sillyhatday/IV-3-Computer-Status-Monitor/IV-3-computer-status-monitor-schematic.pdf

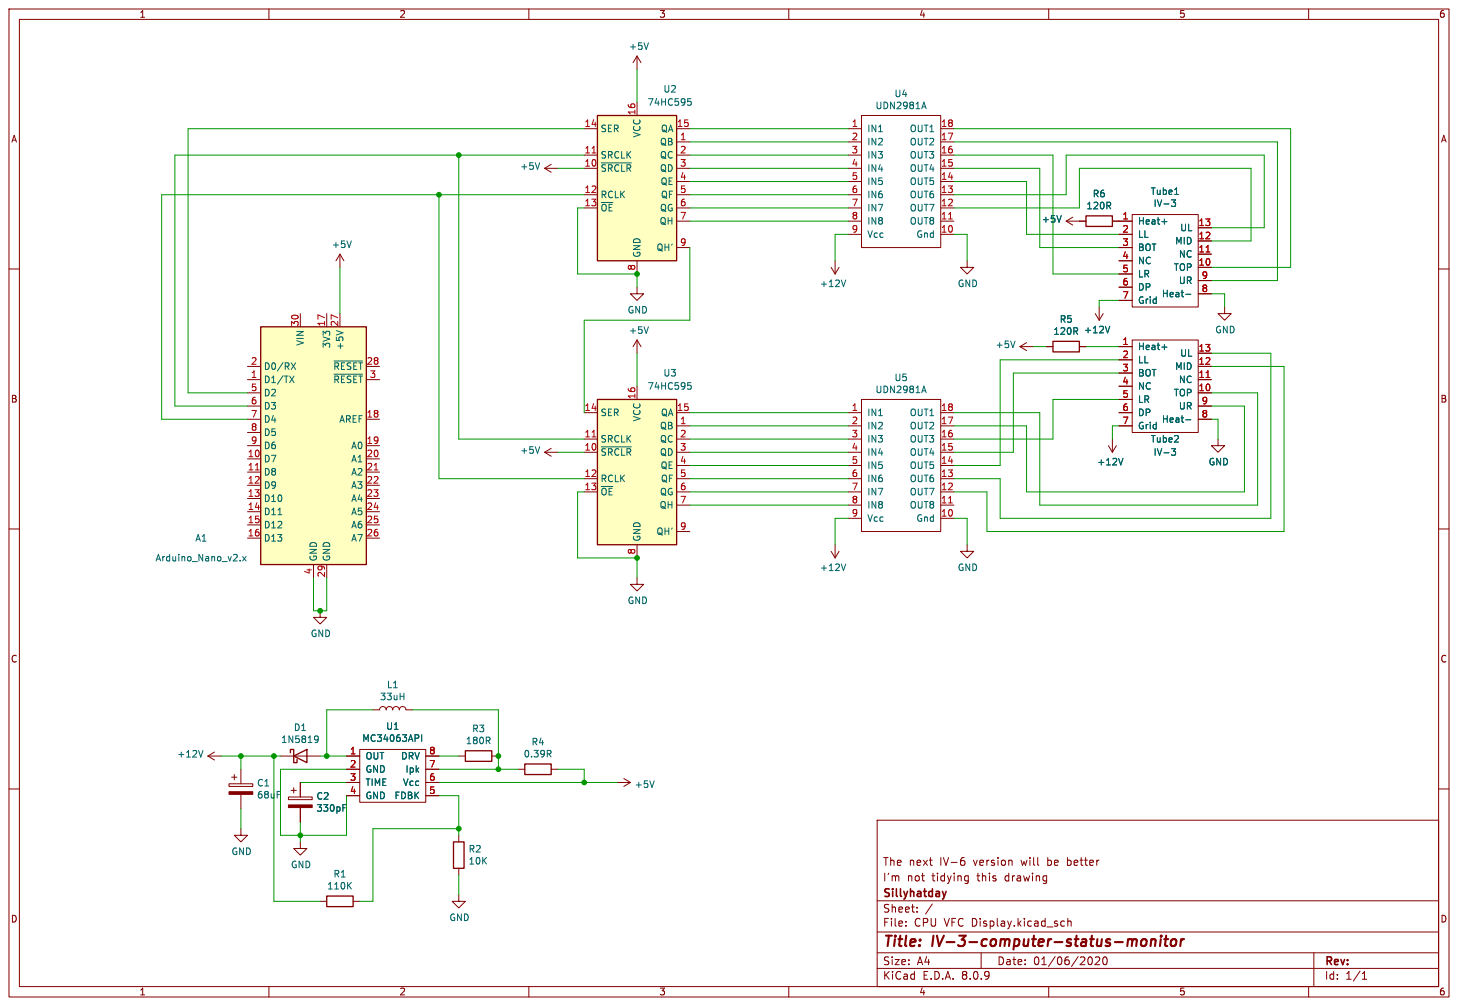
[picture p1: page 1]

I'm not tidying this | IV-6 version will drawing The next | be | better

Display.kicad_sch Sheet: / Sillyhatday | Id: 1/1 Title: IV-3-computer-status-monitor File: CPU VFC
