sillyhatday/IV-3-Computer-Status-Monitor/(commit log)

2025-11-25 Rename ArduinoCpuMonitor.zip to archive/ArduinoCpuMonitor.zip
    Moving file
2025-11-25 Add files via upload
    schematic PDF
2025-11-25 Rename CPU VFC Display.pdf to IV-3-computer-status-monitor-schematic.pdf
    renamed file
2025-11-25 Add files via upload
    Added gerber files
2025-11-25 Add files via upload
    temporary BOM to update later
    [bom.csv]
